tanaes/OvoEasy_Assembly/assembly_BOM.xlsx

Sheet: Fasteners
Table 1
Part | Quantity | Amazon Link | AliExpress Link (aff) | Notes | Sending?
M3 x 8mm self-tapping screw | 13 |  | https://s.click.aliexpress.com/e/_c4DkxSVf
M3 x 16mm self-tapping screw | 26 | https://a.co/d/09zwke4A | https://s.click.aliexpress.com/e/_c4DkxSVf
M2.5 x 8mm socket-head cap screw | 1
M3 x 8mm button-head cap screw | 3
M6 x 20mm shoulder bolt | 1 | https://a.co/d/015Z09Ku | https://s.click.aliexpress.com/e/_c3a7GM7L |  | 3
M3 self-tapping screw assortment | 1 | https://a.co/d/03dw9R8H |  | This isn’t much more expensive than getting the self-tapper screw sizes individually if ordering from Amazon

Sheet: Hardware
Table 1
Part | Quantity | Amazon link | AliExpress Link (aff) | Sending?
M2 x 12mm dowel pin | 6 | https://a.co/d/09a8Rj9t | https://s.click.aliexpress.com/e/_c4MRKhZ3 | 74
M3 x 20mm dowel pin | 2 | https://a.co/d/07THFD3o | https://s.click.aliexpress.com/e/_c4MRKhZ3 | 98
M3 x 35mm dowel pin | 1 | https://a.co/d/0dPRv1Yn | https://s.click.aliexpress.com/e/_c4MRKhZ3 | 49
M2.5 x 3.5D x 4L heat-set insert | 1 | https://a.co/d/0drC5m3B | https://s.click.aliexpress.com/e/_c44qDzBB
M3 thin square nut | 3 | https://a.co/d/05c6LJWb
M3 nylon washer | 2 | https://a.co/d/01vUvN4S |  | 300
M3 x 5D x 8L brass bushing | 2 | https://a.co/d/008EwiJ2 | https://s.click.aliexpress.com/e/_c42RMVd7 | 18
M6 x 8D x 8L brass flange bushing | 1 | https://a.co/d/08GqJfuo | https://s.click.aliexpress.com/e/_c2xWLJfP | 19
6 x 12D x 4.5T thrust bearing | 1 | https://a.co/d/01r2Ntsg | https://s.click.aliexpress.com/e/_c2wZqIU5 | 9
6x3mm neodymium magnet | 8 | https://a.co/d/0c5aRi0s |  | 140
4mm foam cord | 0.002083333333 | https://a.co/d/0ab11rwH |  | 0.003472222222
size 19 rubber band | 2 | https://a.co/d/0iqE4XsH
4oz plastic jar | 1 | https://a.co/d/0j5GJfjn |  | 18
6A 12V power supply | 1 | https://a.co/d/05o4fezS

Sheet: Electrical
Table 1
Item | Quantity | Amazon Link | AliExpress Link (aff) | Notes | Sending?
12V PTC heater module | 1 | https://a.co/d/09HZ0Bi2 | https://s.click.aliexpress.com/e/_c3LvNolJ
5V USB-C humidifier module | 1 | https://a.co/d/0db3pl8A | https://s.click.aliexpress.com/e/_c3RIO8PT |  | 10
IR water level sensor | 1 | https://a.co/d/0216i6jO | https://s.click.aliexpress.com/e/_c3PAcuxF | FS-IR1901 or FS-IR1902 work; can be NO or NC, changed in software. | 2
12V NKP-DC-S08/S10 peristaltic pump | 1 | https://a.co/d/07TiNnoa | https://s.click.aliexpress.com/e/_c3q4hfyD |  | 1
12V 370 diaphragm pump | 1 | https://a.co/d/04BLfb5P | https://s.click.aliexpress.com/e/_c3oF0Pl3 |  | 1
W5500 SPI ethernet module | 1* | https://a.co/d/0hW0p0t8 | https://s.click.aliexpress.com/e/_c4BFZzBr |  | 1
U.FL Patch wifi antenna | 1* | https://a.co/d/0cBm3V7l | https://s.click.aliexpress.com/e/_c45UXlv7 |  | 1
Coax wifi antenna with U.FL extension | 1* | https://a.co/d/02e9HQ7a | https://s.click.aliexpress.com/e/_c40VOnId |  | 1
BME280 module | 1** | https://a.co/d/02nLHARJ | https://s.click.aliexpress.com/e/_c31BQBBB
AHT30 module | 1** | https://a.co/d/0e9sNEoe | https://s.click.aliexpress.com/e/_c2QPLvpx
2.4” IL9341 TFT display | 1 | https://a.co/d/0d9ri7bP | https://s.click.aliexpress.com/e/_c3RWLmwZ
 | */**: only one of these options required
