tanaes/OvoEasy_Assembly/STLs/Controller_Module/main_cover.stl

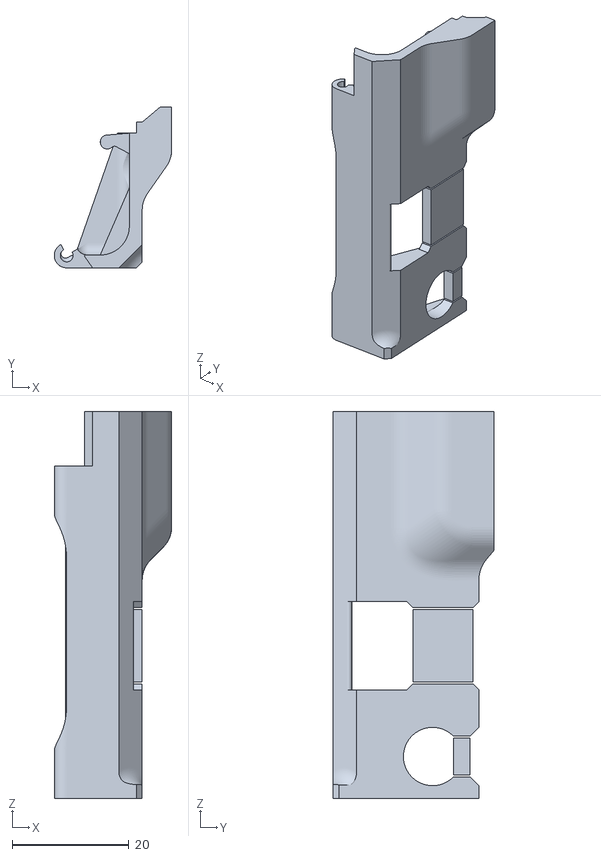
[picture p6: CAD file, 2026-04-02]
STLs/Controller_Module/main_cover.stl
20.1 x 27.6 x 66.4
