tanaes/OvoEasy_Assembly/STLs/Controller_Module/main_diffuser.stl

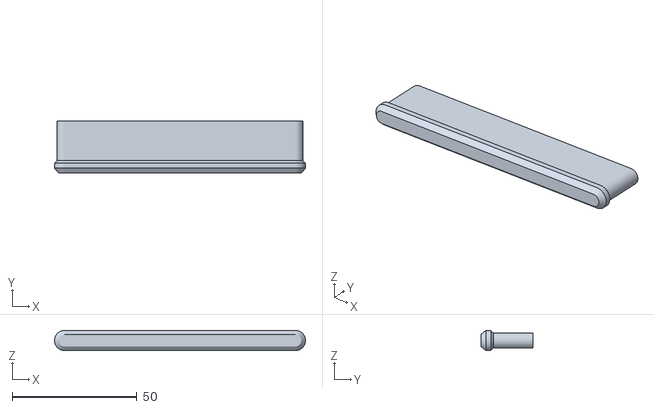
[picture p7: CAD file, 2026-04-02]
STLs/Controller_Module/main_diffuser.stl
100.7 x 21.0 x 8.10
