tanaes/OvoEasy_Assembly/DXFs/rear_acrylic.dxf

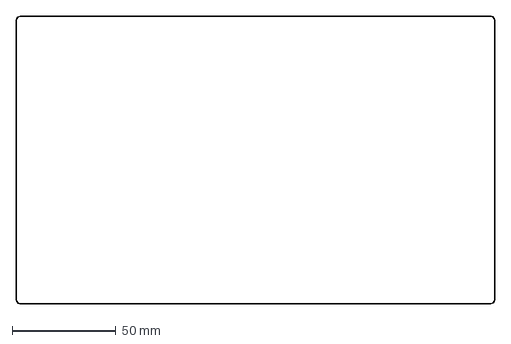
[picture p8: CAD file, 2026-04-02]
DXFs/rear_acrylic.dxf
230.6 x 138.6 mm
