tanaes/OvoEasy_Assembly/STLs/Controller_Module/usb_cover.stl

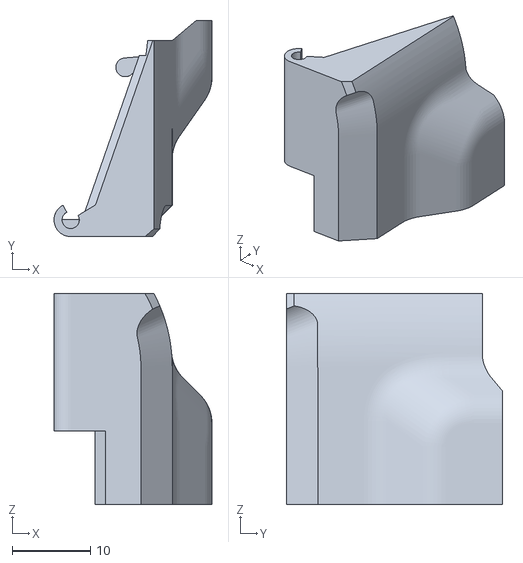
[picture p9: CAD file, 2026-04-02]
STLs/Controller_Module/usb_cover.stl
20.1 x 27.6 x 26.9
