tanaes/OvoEasy_Assembly/STLs/Door_Module/Door.stl

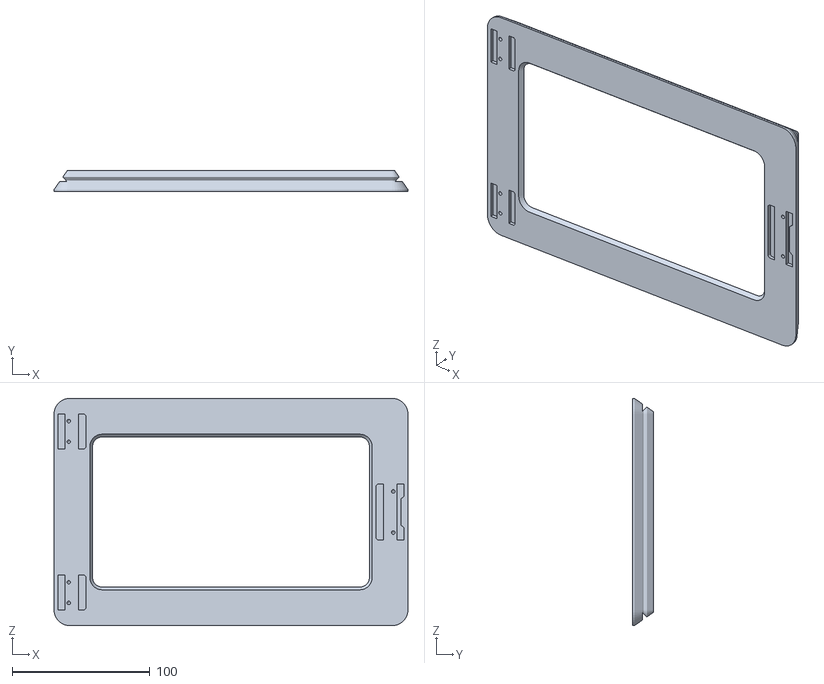
[picture p10: CAD file, 2026-03-06]
STLs/Door_Module/Door.stl
257.0 x 15.3 x 165.0
