tanaes/OvoEasy_Assembly/STLs/Frame/Frame.stl

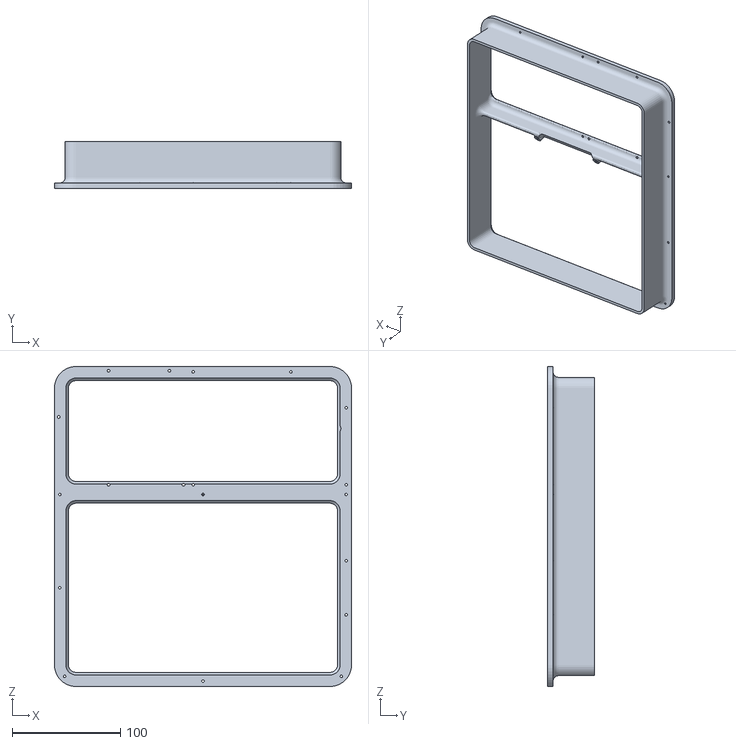
[picture p11: CAD file, 2026-04-08]
STLs/Frame/Frame.stl
274.0 x 43.0 x 295.0
