tanaes/OvoEasy_Assembly/STLs/Humidity_Module/reservoir_lid.stl

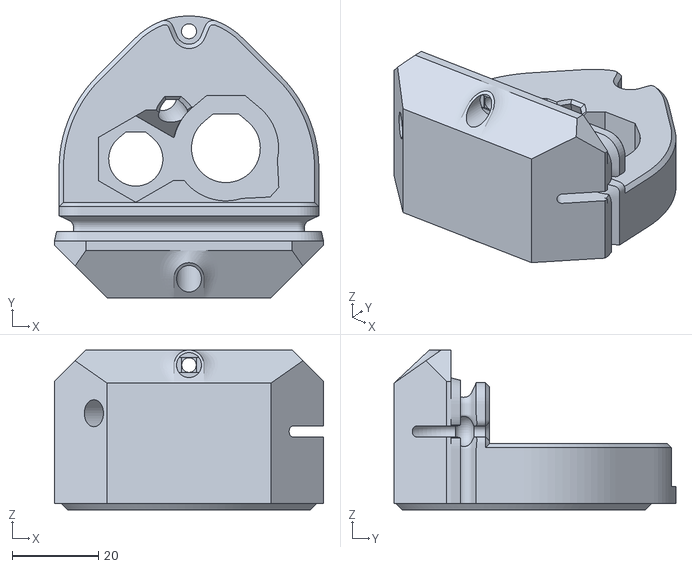
[picture p12: CAD file, 2026-04-02]
STLs/Humidity_Module/reservoir_lid.stl
62.6 x 65.6 x 37.2
