tanaes/OvoEasy_Assembly/Tools/Soldering_Jigs_incubator_controller-production_top_jig.stl

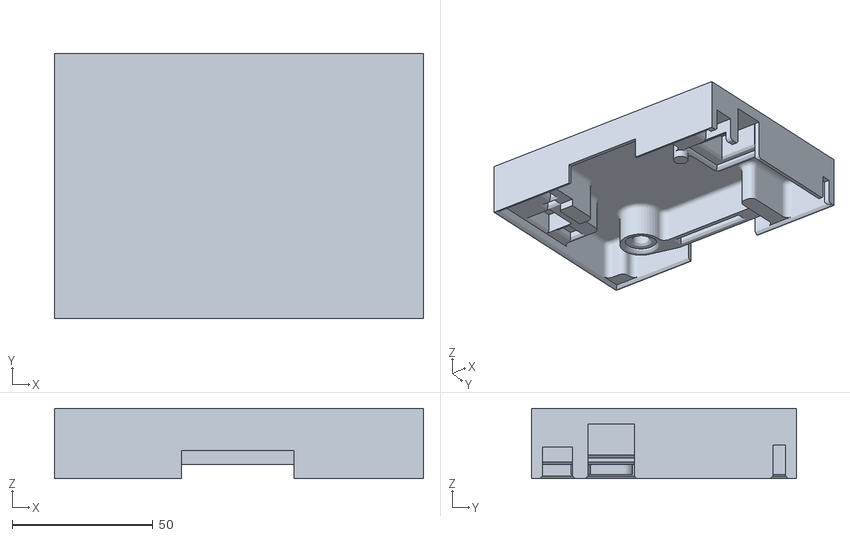
[picture p13: CAD file, 2026-03-26]
Tools/Soldering_Jigs_incubator_controller-production_top_jig.stl
131.0 x 94.0 x 25.0
