tanaes/OvoEasy_Assembly/DXFs/front_acrylic.dxf

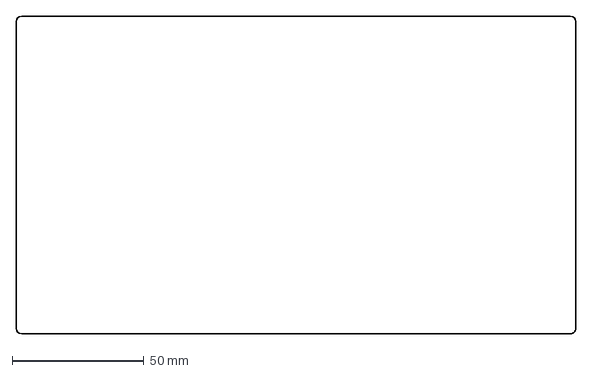
[picture p14: CAD file, 2026-04-02]
DXFs/front_acrylic.dxf
212.7 x 120.7 mm
