tanaes/OvoEasy_Assembly/STLs/Controller_Module/front_panel.stl

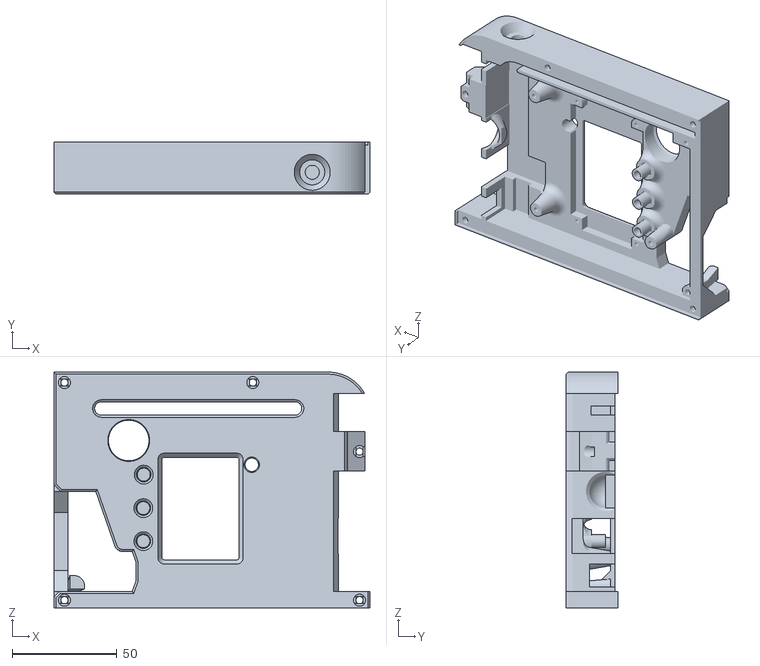
[picture p15: CAD file, 2026-04-02]
STLs/Controller_Module/front_panel.stl
151.0 x 25.0 x 112.7
