tanaes/OvoEasy_Assembly/STLs/Door_Module/Door frame - integrated latch.stl

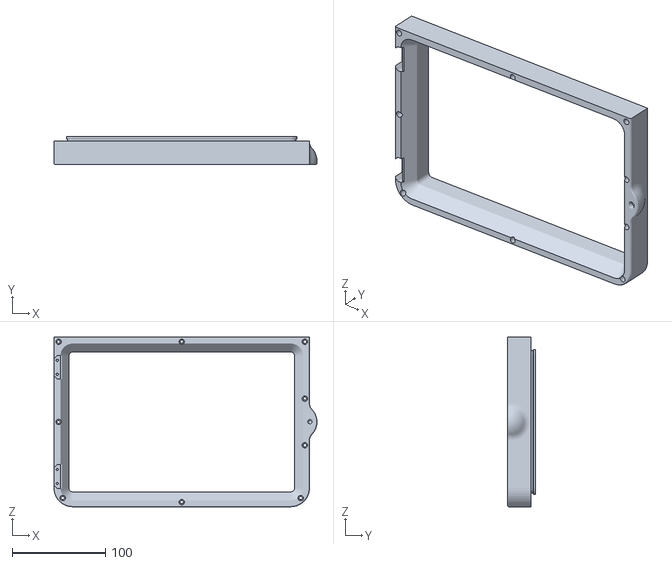
[picture p16: CAD file, 2026-03-06]
STLs/Door_Module/Door frame - integrated latch.stl
282.1 x 30.0 x 181.9
