tanaes/OvoEasy_Assembly/STLs/Humidity_Module/reservoir_carrier.stl

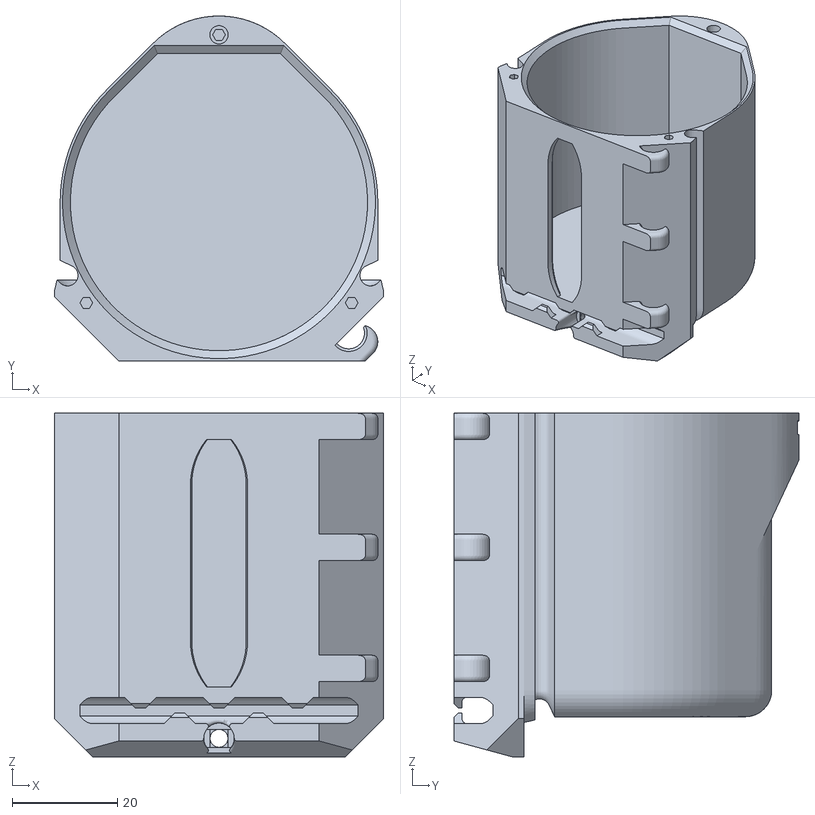
[picture p17: CAD file, 2026-04-02]
STLs/Humidity_Module/reservoir_carrier.stl
62.6 x 65.6 x 65.3
