tanaes/OvoEasy_Assembly/Tools/Soldering_Jigs_incubator_controller-production_bottom_jig.stl

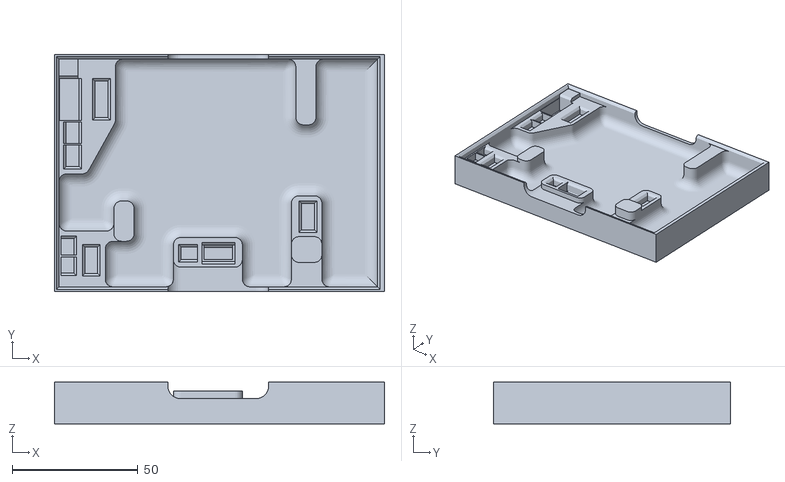
[picture p18: CAD file, 2026-03-26]
Tools/Soldering_Jigs_incubator_controller-production_bottom_jig.stl
131.0 x 94.0 x 16.5
