tanaes/OvoEasy_Assembly/STLs/Controller_Module/camera_diffuser.stl

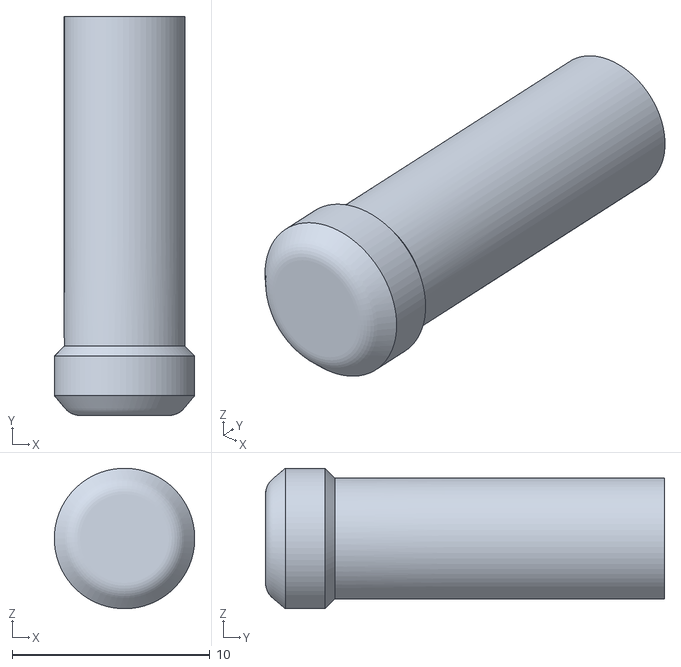
[picture p19: CAD file, 2026-04-02]
STLs/Controller_Module/camera_diffuser.stl
7.10 x 20.2 x 7.10
