tanaes/OvoEasy_Assembly/STLs/Door_Module/hinge_frame.stl

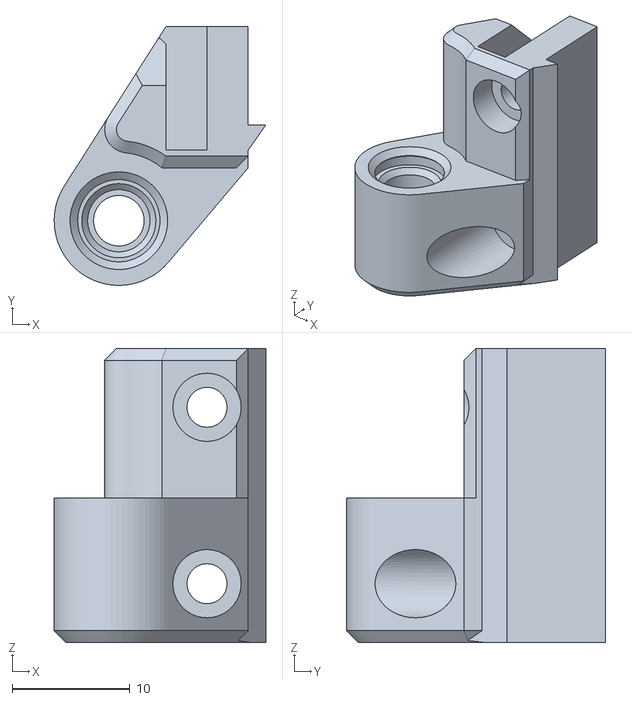
[picture p20: CAD file, 2026-03-06]
STLs/Door_Module/hinge_frame.stl
18.0 x 22.0 x 25.0
