tanaes/OvoEasy_Assembly/STLs/Humidity_Module/humidity_frame.stl

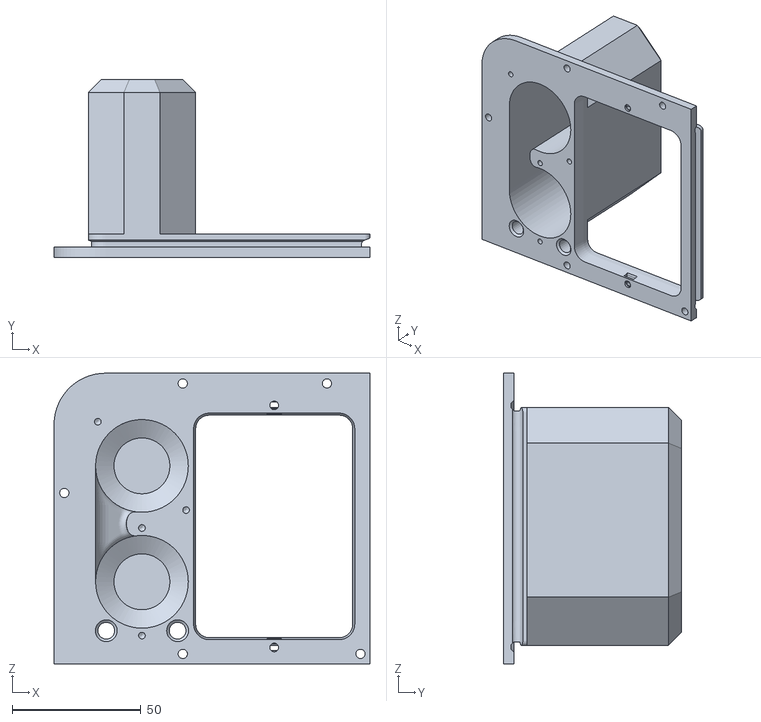
[picture p21: CAD file, 2026-04-02]
STLs/Humidity_Module/humidity_frame.stl
122.7 x 69.0 x 112.9
