tanaes/OvoEasy_Assembly/STLs/Controller_Module/back_panel.stl

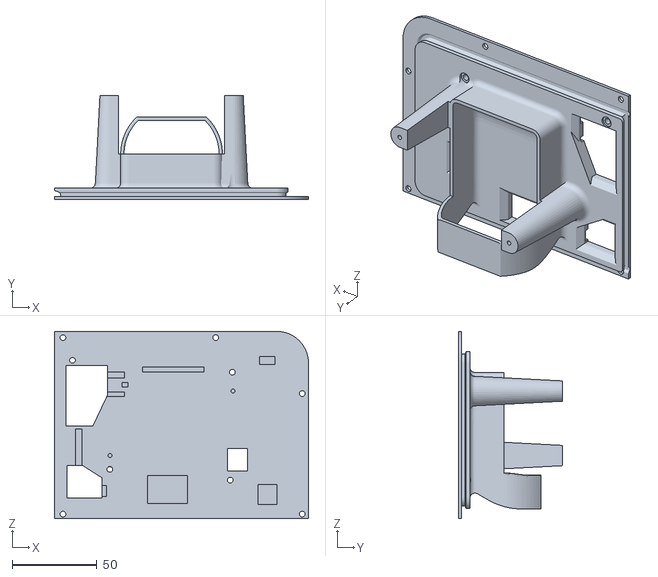
[picture p22: CAD file, 2026-04-02]
STLs/Controller_Module/back_panel.stl
149.7 x 61.1 x 110.4
