tanaes/OvoEasy_Assembly/STLs/Door_Module/latch - latch dog.stl

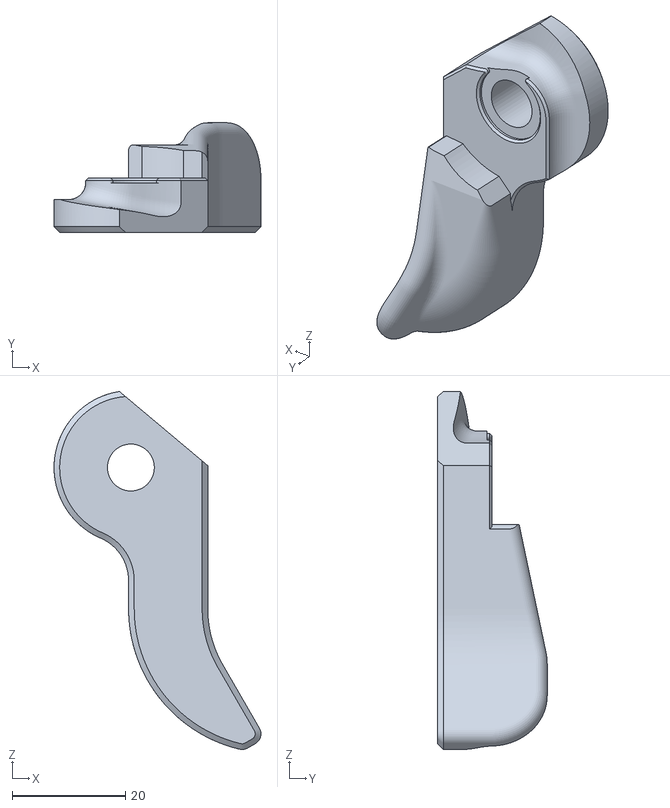
[picture p23: CAD file, 2026-03-06]
STLs/Door_Module/latch - latch dog.stl
36.6 x 19.4 x 63.3
