tanaes/OvoEasy_Assembly/STLs/Humidity_Module/370_carrier_print_OvoEasy Door_carrier.stl

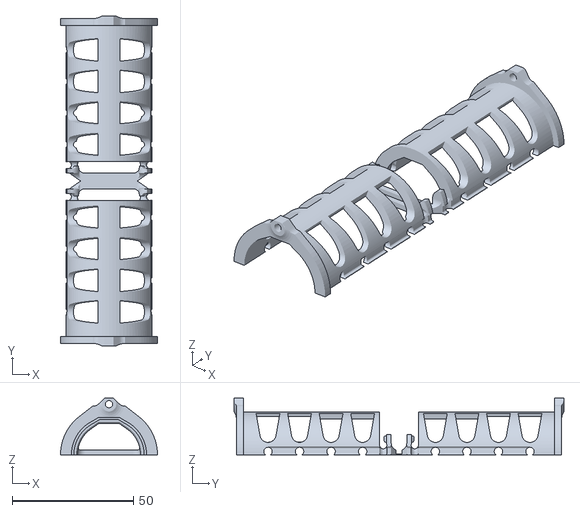
[picture p24: CAD file, 2026-04-02]
STLs/Humidity_Module/370_carrier_print_OvoEasy Door_carrier.stl
40.0 x 136.0 x 23.4
