tanaes/OvoEasy_Assembly/STLs/Door_Module/hinge_door.stl

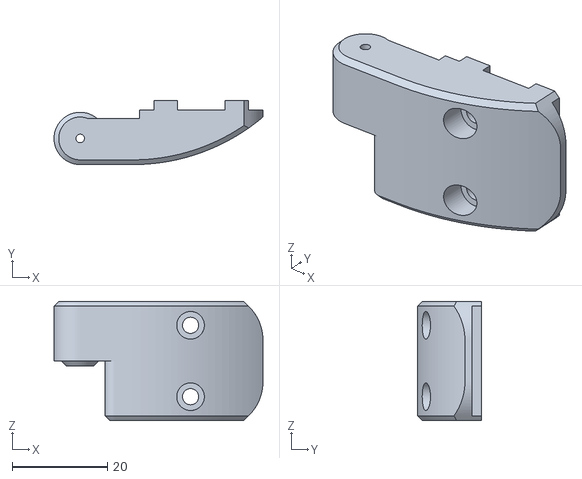
[picture p25: CAD file, 2026-03-06]
STLs/Door_Module/hinge_door.stl
43.9 x 13.5 x 25.0
