tanaes/OvoEasy_Assembly/STLs/Humidity_Module/370_carrier_print_OvoEasy Door_support2.stl

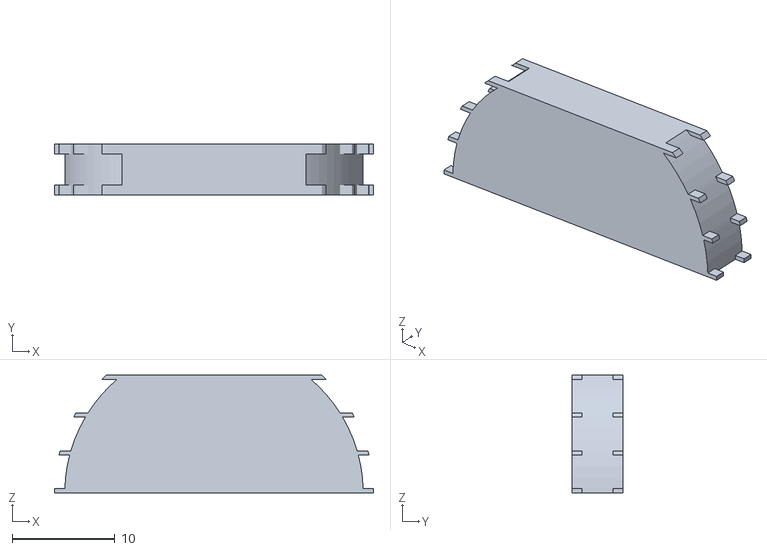
[picture p26: CAD file, 2026-04-02]
STLs/Humidity_Module/370_carrier_print_OvoEasy Door_support2.stl
31.0 x 5.00 x 11.4
