tanaes/OvoEasy_Assembly/STLs/Humidity_Module/humidity_cover.stl

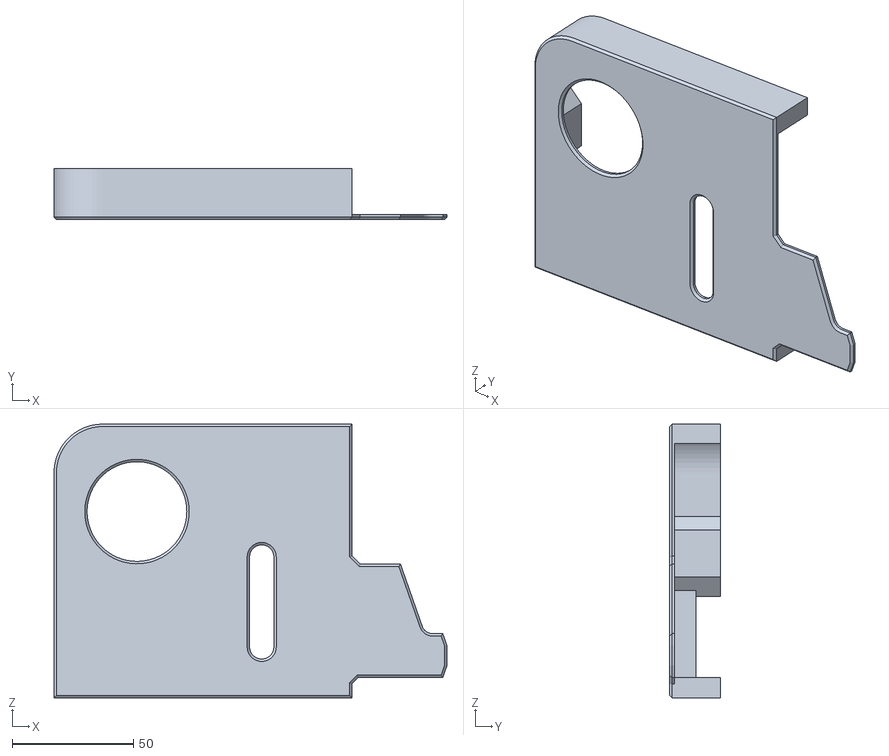
[picture p27: CAD file, 2026-04-02]
STLs/Humidity_Module/humidity_cover.stl
161.8 x 21.0 x 112.7
