tanaes/OvoEasy_Assembly/STLs/Controller_Module/encoder_knob.stl

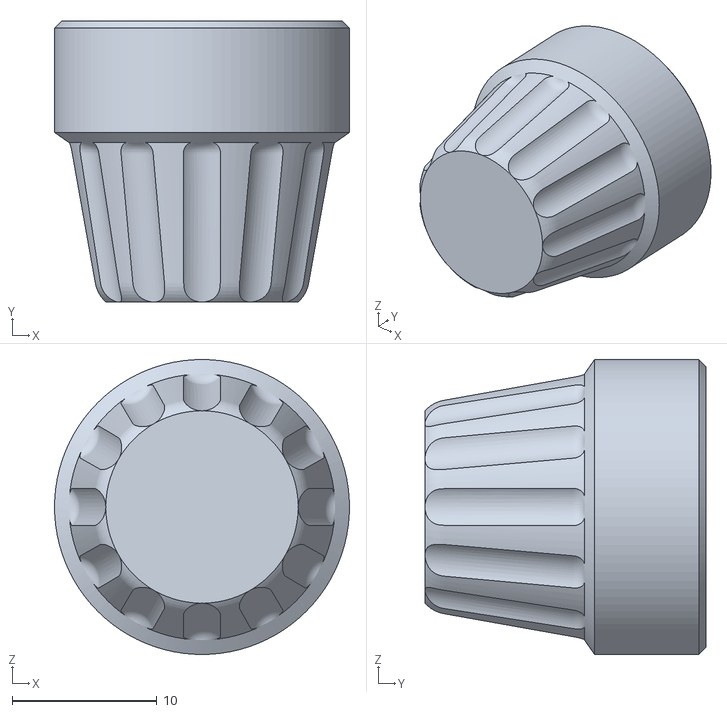
[picture p28: CAD file, 2026-04-02]
STLs/Controller_Module/encoder_knob.stl
20.4 x 19.4 x 20.4
