tanaes/OvoEasy_Assembly/STLs/Door_Module/Catch.stl

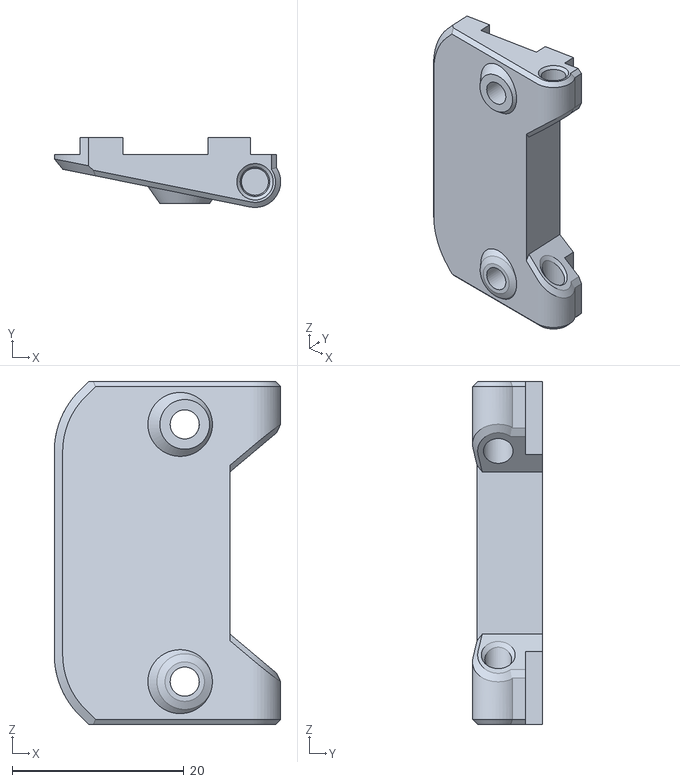
[picture p29: CAD file, 2026-03-06]
STLs/Door_Module/Catch.stl
26.4 x 8.15 x 40.0
