tanaes/OvoEasy_Assembly/(list of files, cad)

Other CAD files:
STLs/Humidity_Module/370_carrier_print_OvoEasy Door_support1.stl
STLs/Door_Module/latch - bolt cap.stl
