tanaes/OvoEasy_Assembly/(commit log)

2026-03-06 Initial commit with door and frame STLs
    [Catch.stl, Door frame - integrated latch.stl, Door.stl, Frame.stl, hinge_door.stl, hinge_frame.stl, latch - bolt cap.stl, latch - latch dog.stl]
2026-03-26 added PCB assembly instructions
2026-03-26 added soldering jigs
    [Soldering_Jigs_incubator_controller-production_bottom_jig.stl, Soldering_Jigs_incubator_controller-production_top_jig.stl]
2026-03-26 added note about pin headers
2026-03-27 Fix image paths in PCB assembly instructions
    Updated image file paths for assembly steps in PCB_assembly.md.
2026-04-02 added module prints and BOM
    [370_carrier_print_OvoEasy Door_carrier.stl, 370_carrier_print_OvoEasy Door_support1.stl, 370_carrier_print_OvoEasy Door_support2.stl, BOM.xlsx, assembly_BOM.xlsx, back_panel.stl, camera_diffuser.stl, encoder_knob.stl]
2026-04-02 added CAD
2026-04-02 added DXFs
    [front_acrylic.dxf, rear_acrylic.dxf]
2026-04-08 fixed frame pilot holes
    [Frame.stl]
